a-DNA-py/TIDI/Hardware/esp32.jpg

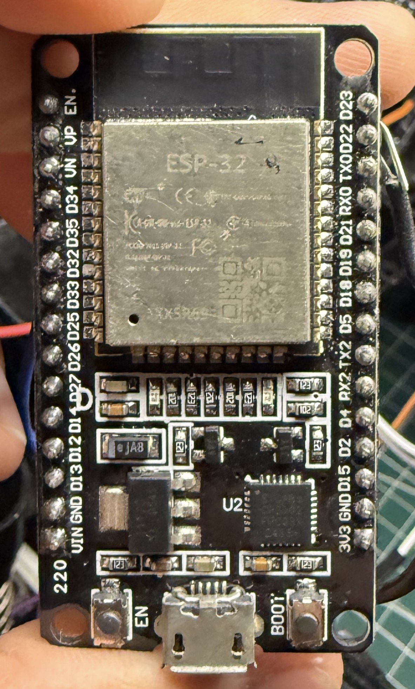
Hardware/esp32.jpg
