a-DNA-py/TIDI/(commit log)

2026-10-20 TIDI: ESP32 firmware, room-scan host script and wiring for a rebuilt RC car
2026-10-20 Add the bill of materials
2026-10-20 Write the firmware comments, schematic notes and .gitignore for readers of the repo
